hor63/hovImuBoard/hovImuBoard_BOM.xlsx

Reference | Value | Description | Digi-Key_PN | MPN | Manufacturer | Qty
> C1, C2 | 100nF | CAP CER 0.1UF 25V X7R 0603 Non-magnetic | 1608-1295-1-ND | 060330160104JXT | Knowles Syfer | 2
> C6, C7, C10, C25-C27 | 100nF | CAP CER 0.1UF 25V X7R 0603 | 311-1341-1-ND | CC0603KRX7R8BB104 | Yageo | 6
> C8, C9 | 20pF | CAP CER 20PF 50V C0G/NPO 0603 | 311-1424-1-ND | CC0603JRNPO9BN200 | Yageo | 2
> C3, C5, C12 | 4.7uF | CAP CER 4.7UF 25V X7R 1206 | 399-8204-1-ND | C1206C475K3RACTU | KEMET | 3
> C11, C13, C14, C16, C21 | 22uF | CAP CER 22UF 25V X7R 1210 | 1276-3392-1-ND | CL32B226KAJNNNE | Samsung Electro-Mechanics | 5
> D1, D2 | LED Green/Red | LED GREEN/RED CLEAR 4SMD | 754-1955-1-ND | APHB1608LZGKSURKC | Kingbright | 2
D3 | VESD16C1-02V-G3-08 | ESD PROTECTION DIODE 17V 6.3A SOD-523 | VESD16C1-02V-G3-08GICT-ND | VESD16C1-02V-G3-08 | Vishay Semiconductor Diodes Division | 1
H1 | Box |  | 377-1757-ND | CU-1935-MB | Bud Industries | 1
J1 | AVR-ISP-6 | TE_1761681-1 | A122759-ND | 1761681-1 | TE Connectivity AMP Connectors | 1
J3 | 54602-908LF | CONN MOD JACK 8P8C R/A UNSHLD | 609-1046-ND | 54602-908LF | Amphenol ICC (FCI) | 1
J4 | AVR-JTAG-10 | SHF-105-01-L-D-TH | SAM10711-ND | SHF-105-01-L-D-TH | Samtec Inc. | 1
L1 | 240nH | FIXED IND 240NH 2.4A 50 MOHM | 490-15988-1-ND | LQM21PNR24MEHD | Murata Electronics | 1
L2 | 1.2uH | FIXED IND 1.2UH 2.9A 36 MOHM | 490-14180-1-ND | 1231AS-H-1R2N=P3 | Murata Electronics | 1
L3 | 8.2uH | FIXED IND 8.2UH 1.3A 128 MOHM | 490-16860-1-ND | LQH43PN8R2M26L | Murata Electronics | 1
> L4, L5 | 2.2uH | FIXED IND 2.2UH 2.1A 78 MOHM | 490-15950-1-ND | LQH3NPN2R2MMEL | Murata Electronics | 2
R1 | 100k |  | 541-100KCCT-ND | CRCW0805100KFKEA | Vishay Dale | 1
> R2, R5 | 330 | RES SMD 330 OHM 1% 1/10W 0603 | P330HCT-ND | ERJ-3EKF3300V | Panasonic Electronic Components | 2
> R3, R7 | 787 | RES SMD 787 OHM 1% 1/10W 0603 | P787HCT-ND | ERJ-3EKF7870V | Panasonic Electronic Components | 2
R4 | 180m | RES 0.18 OHM 1% 1/2W 0805 | P19314CT-ND | ERJ-6DSFR18V | Panasonic Electronic Components | 1
R6 | 100 | RES SMD 100 OHM 1% 1/4W 0603 | P100BYCT-ND | ERJ-PA3F1000V | Panasonic Electronic Components | 1
> R8, R9 | 4.7k | RES SMD 4.7K OHM 1% 1/10W 0603 | P4.70KHCT-ND | ERJ-3EKF4701V | Panasonic Electronic Components | 2
R10 | 100k | RES SMD 100K OHM 1% 1/10W 0603 | P100KHCT-ND | ERJ-3EKF1003V | Panasonic Electronic Components | 1
> R11, R12 | 47 | RES SMD 47 OHM 1% 1/10W 0603 | P47.0HCT-ND | ERJ-3EKF47R0V | Panasonic Electronic Components | 2
S1 | MCSLPT4644B1PHTR |  | 450-3383-1-ND | MCSLPT4644B1PHTR | TE Connectivity ALCOSWITCH Switches | 1
U1 | LD2981 |  | 497-1524-1-ND | LD2981ABU33TR | STMicroelectronics | 1
U2 | BMX160 | Accelerometer, Gyroscope, Magnetometer, 3 Axis Sensor I²C, SPI Output | 828-1087-1-ND | BMX160 | Bosch Sensortec | 1
U3 | SN65LVDS179DR | LVDS TRANSCEIVER FULL 1/1 8SOIC | 296-46329-1-ND | SN65LVDS179DR | Texas Instruments | 1
U4 | ATmega1284P-AU | IC MCU 8BIT 128KB FLASH 44TQFP | ATmega1284P-AU-ND | ATmega1284P-AU | Microchip Technology | 1
U5 | TPS62173DSG | IC REG BUCK 5V 500MA 8WSON | 296-39450-1-ND | TPS62173DSGR | Texas Instruments | 1
U6 | TPS62172DSG | IC REG BUCK 3.3V 500MA 8WSON | 296-39449-1-ND | TPS62172DSGR | Texas Instruments | 1
XTAL1 | 9,216MHz | CRYSTAL 9.2160MHZ 20PF SMD | XC1274CT-ND | ECS-92.1-20-5PX-TR | ECS Inc. | 1
