hor63/hovImuBoard/hovSerialAdapter/hovSerialAdapter_BOM.xlsx

Reference | Value | Description | Digi-Key_PN | MPN | Manufacturer | Qty
C1 | 2.2uF | CAP CER 2.2UF 25V X7R 0805 | 1276-2954-1-ND | CL21B225KAFNNNE | Samsung Electro-Mechanics | 1
> C3-C9 | 100nF | CAP CER 0.1UF 25V X7R 0603 | 311-1341-1-ND | CC0603KRX7R8BB104 | Yageo | 7
C10 | 4.7uF | CAP CER 4.7UF 25V X7R 1206 | 399-8204-1-ND | C1206C475K3RACTU | KEMET | 1
> C2, C11-C13 | 22uF | CAP CER 22UF 25V X7R 1210 | 1276-3392-1-ND | CL32B226KAJNNNE | Samsung Electro-Mechanics | 4
> D1, D2 | VESD16C1-02V-G3-08 | ESD PROTECTION DIODE 17V 6.3A SOD-523 | VESD16C1-02V-G3-08GICT-ND | VESD16C1-02V-G3-08 | Vishay Semiconductor Diodes Division | 2
H1 | Box | BOX PLASTIC GRAY 2.56"L X 1.97"W | HM5530-ND | MB655030 | Hammond Manufacturing | 1
J2 | Power jack | CONN PWR JACK 2X5.5MM SOLDER | CP-036AHPJCT-ND | PJ-036AH-SMT-TR | CUI Devices | 1
J3 | DB9_Female | CONN DSUB RCPT 9POS SLDR CUP | L77SDE09S-ND | L77SDE09S | Amphenol ICC (Commercial Products) | 1
J4 | Ext. Power | PinHeader1x02 P2.54mm Vertical |  |  |  | 1
> J1, J5 | 54602-908LF | CONN MOD JACK 8P8C R/A UNSHLD | 609-1046-ND | 54602-908LF | Amphenol ICC (FCI) | 2
J6 | RX | PinHeader1x02 P2.54mm Vertical |  |  |  | 1
J7 | TX | PinHeader1x02 P2.54mm Vertical |  |  |  | 1
L1 | 4.7uH | FIXED IND 4.7UH 1.6A 90 MOHM SMD | 490-13388-1-ND | LQH43PN4R7M26L | Murata Electronics | 1
L2 | 240nH | FIXED IND 240NH 2.4A 50 MOHM | 490-15988-1-ND | LQM21PNR24MEHD | Murata Electronics | 1
L3 | 1.2uH | FIXED IND 1.2UH 2.9A 36 MOHM | 490-14180-1-ND | 1231AS-H-1R2N=P3 | Murata Electronics | 1
L4 | 8.2uH | FIXED IND 8.2UH 1.3A 153.6 MOHM | 490-16115-1-ND | LQH43PH8R2M26L | Murata Electronics | 1
L5 | 2.2uH | FIXED IND 2.2UH 2.1A 78 MOHM | 490-15950-1-ND | LQH3NPN2R2MMEL | Murata Electronics | 1
LOGO1 | Logo_Open_Hardware_Small |  |  |  |  | 1
R1 | 1.5 | RES SMD 1.5 OHM 1% 1/2W 0805 | P19272CT-ND | ERJ-6DQF1R5V | Panasonic Electronic Components | 1
R2 | 100 | RES SMD 100 OHM 1% 1/4W 0603 | P100BYCT-ND | ERJ-PA3F1000V | Panasonic Electronic Components | 1
R3 | 180m | RES 0.18 OHM 1% 1/2W 0805 | P19314CT-ND | ERJ-6DSFR18V | Panasonic Electronic Components | 1
TP1 | +12V |  |  |  |  | 1
TP2 | +3.3V |  |  |  |  | 1
U1 | MAX3232 | IC TRANSCEIVER FULL 2/2 16TSSOP | 296-13100-1-ND | MAX3232IPWR | Texas Instruments | 1
U2 | SN65LVDS179DR | LVDS TRANSCEIVER FULL 1/1 8SOIC | 296-46329-1-ND | SN65LVDS179DR | Texas Instruments | 1
U3 | TPS62172DSG | IC REG BUCK 3.3V 500MA 8WSON | 296-39449-1-ND | TPS62172DSGR | Texas Instruments | 1
