hor63/hovImuBoard/hovSerialAdapter/hovSerialAdapter.kicad_pcb

## KiCad design hovSerialAdapter/hovSerialAdapter.kicad_pcb (2022-01-31)

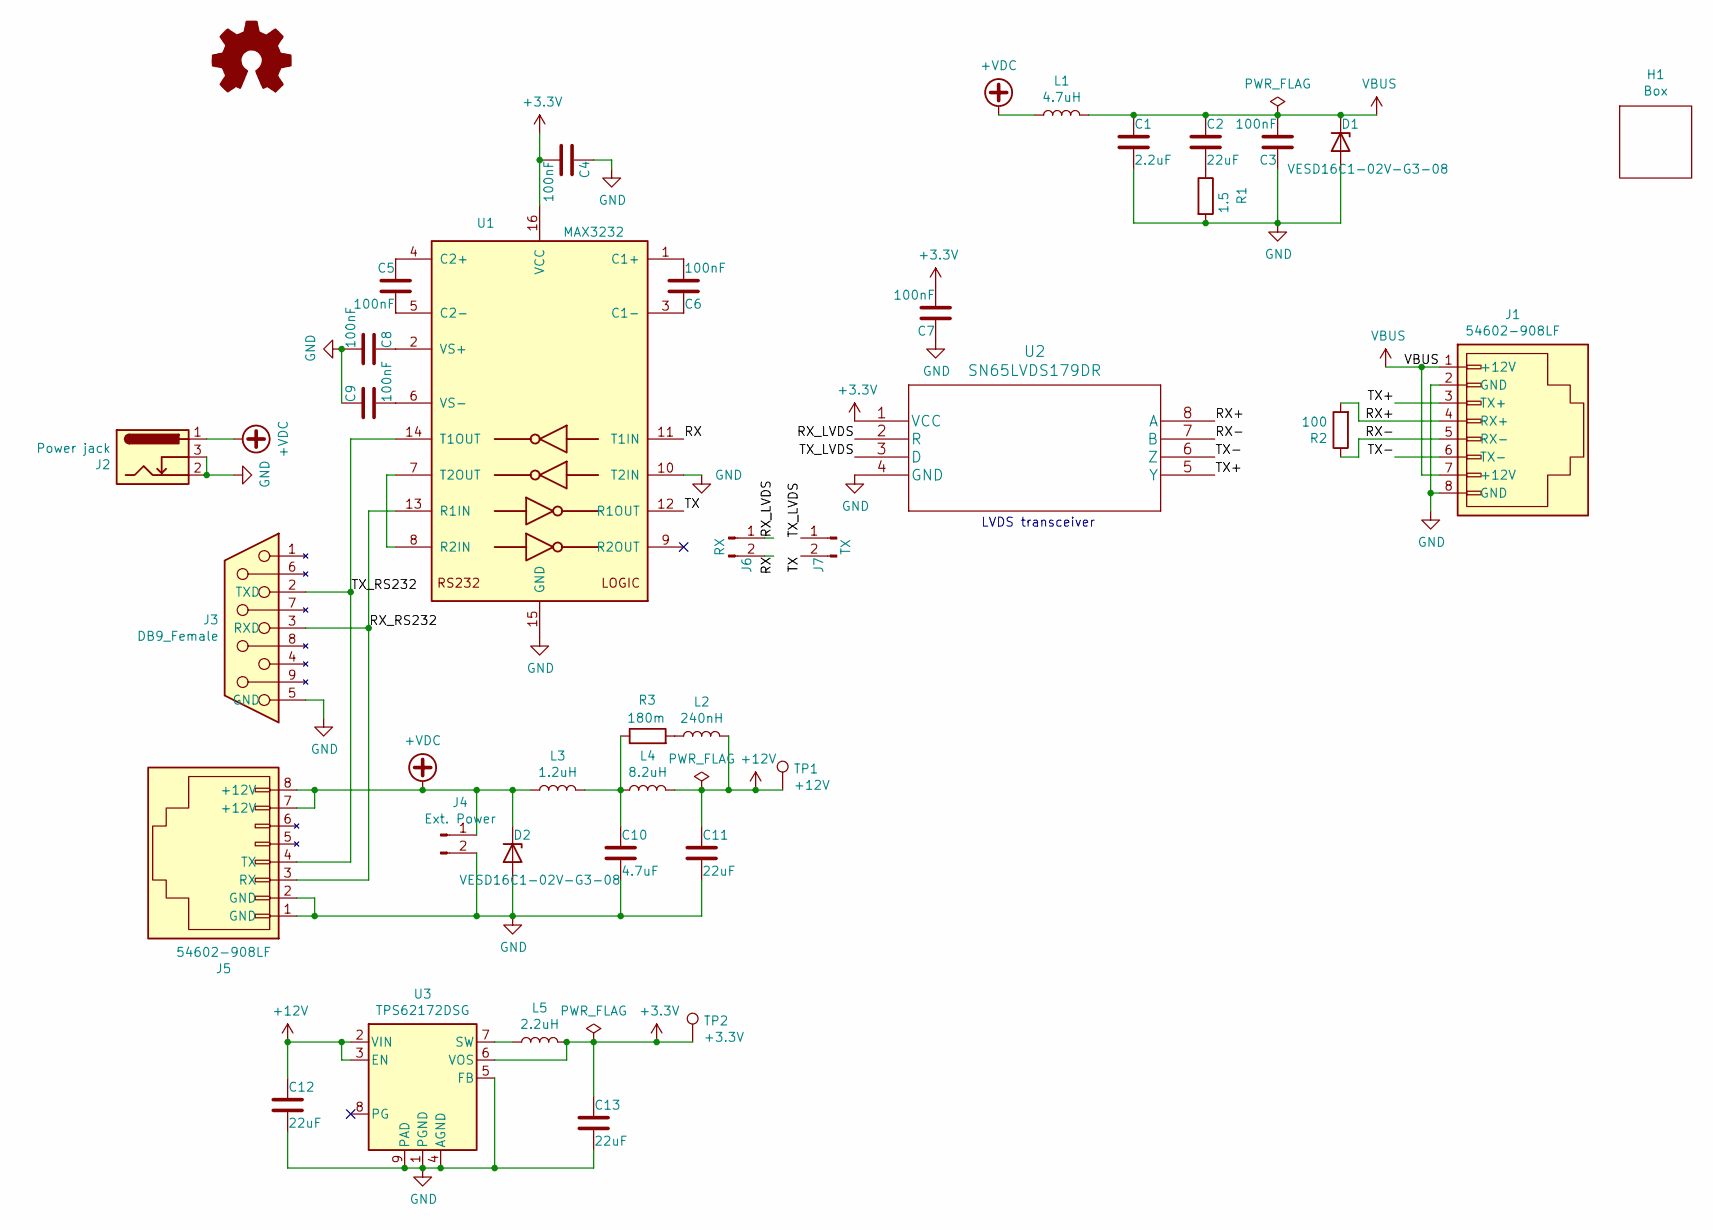
[picture p1: schematic hovSerialAdapter.kicad_sch, horOpenVario serial converter for IMU board]

Parts:
C1: 2.2uF; C_0805_2012Metric; MPN CL21B225KAFNNNE; Digi-Key_PN 1276-2954-1-ND
C2, C11, C12, C13: 22uF; C_1210_3225Metric; MPN CL32B226KAJNNNE; Digi-Key_PN 1276-3392-1-ND
C3, C4, C5, C6, C7, C8, C9: 100nF; C_0603_1608Metric; MPN CC0603KRX7R8BB104; Digi-Key_PN 311-1341-1-ND
C10: 4.7uF; C_1206_3216Metric; MPN C1206C475K3RACTU; Digi-Key_PN 399-8204-1-ND
D1, D2: VESD16C1-02V-G3-08; D_SOD-523; MPN VESD16C1-02V-G3-08; Digi-Key_PN VESD16C1-02V-G3-08GICT-ND
H1: Box; Box-MB655030; MPN MB655030; Digi-Key_PN HM5530-ND
J1, J5: 54602-908LF; Ethernet_Jack_54602-908LF; MPN 54602-908LF; Digi-Key_PN 609-1046-ND
J2: Power jack; CUI_PJ-036AH-SMT-TR; MPN PJ-036AH-SMT-TR; Digi-Key_PN CP-036AHPJCT-ND
J3: DB9_Female; DSUB-9_Female_EdgeMount_P2.77mm; MPN L77SDE09S; Digi-Key_PN L77SDE09S-ND
J4: Ext. Power; PinHeader_1x02_P2.54mm_Vertical
J6: RX; PinHeader_1x02_P2.54mm_Vertical
J7: TX; PinHeader_1x02_P2.54mm_Vertical
L1: 4.7uH; L_1812_4532Metric; MPN LQH43PN4R7M26L; Digi-Key_PN 490-13388-1-ND
L2: 240nH; L_0805_2012Metric; MPN LQM21PNR24MEHD; Digi-Key_PN 490-15988-1-ND
L3: 1.2uH; IND_1231AS-H-1R2N=P3; MPN 1231AS-H-1R2N=P3; Digi-Key_PN 490-14180-1-ND
L4: 8.2uH; IND_LQH43PH8R2M26L; MPN LQH43PH8R2M26L; Digi-Key_PN 490-16115-1-ND
L5: 2.2uH; IND_LQH3NPN2R2MMEL; MPN LQH3NPN2R2MMEL; Digi-Key_PN 490-15950-1-ND
LOGO1: Logo_Open_Hardware_Small; OSHW-Symbol_6.7x6mm_SilkScreen
R1: 1.5; R_0805_2012Metric; MPN ERJ-6DQF1R5V; Digi-Key_PN P19272CT-ND
R2: 100; R_0603_1608Metric; MPN ERJ-PA3F1000V; Digi-Key_PN P100BYCT-ND
R3: 180m; R_0805_2012Metric; MPN ERJ-6DSFR18V; Digi-Key_PN P19314CT-ND
TP1: +12V; TestPoint_THTPad_D1.0mm_Drill0.5mm
TP2: +3.3V; TestPoint_THTPad_D1.0mm_Drill0.5mm
U1: MAX3232; TSSOP-16_4.4x5mm_P0.65mm; MPN MAX3232IPWR; Digi-Key_PN 296-13100-1-ND
U2: SN65LVDS179DR; SOIC-8_3.9x4.9mm_P1.27mm; MPN SN65LVDS179DR; Digi-Key_PN 296-46329-1-ND
U3: TPS62172DSG; WSON-8-1EP_2x2mm_P0.5mm_EP0.9x1.6mm_ThermalVias; MPN TPS62172DSGR; Digi-Key_PN 296-39449-1-ND

Connections:
+3V3: C4.1, C7.1, C13.2, L5.2, TP2.1, U1.16 (VCC), U2.1 (VCC), U3.6 (VOS)
+12V: C11.2, C12.2, L2.2, L4.2, TP1.1, U3.2 (VIN), U3.3 (EN)
+VDC: D2.1 (K), J2.1, J4.1, J5.7 (+12V), J5.8 (+12V), L1.1, L3.1
/RX: J6.2, U1.11 (T1IN)
/RX+: J1.4 (RX+), R2.2, U2.8 (A)
/RX-: J1.5 (RX-), R2.1, U2.7 (B)
/RX_LVDS: J6.1, U2.2 (R)
/RX_RS232: J3.3 (RXD), J5.3 (RX), U1.13 (R1IN)
/TX: J7.2, U1.12 (R1OUT)
/TX+: J1.3 (TX+), U2.5 (Y)
/TX-: J1.6 (TX-), U2.6 (Z)
/TX_LVDS: J7.1, U2.3 (D)
/TX_RS232: J3.2 (TXD), J5.4 (TX), U1.14 (T1OUT)
GND: C1.1, C3.2, C4.2, C7.2, C8.1, C9.2, C10.1, C11.1, C12.1, C13.1, D1.2 (A), D2.2 (A), J1.2 (GND), J1.8 (GND), J2.2, J2.3, J3.5 (GND), J4.2, J5.1 (GND), J5.2 (GND), R1.2, U1.10 (T2IN), U1.15 (GND), U2.4 (GND), U3.1 (PGND), U3.4 (AGND), U3.5 (FB), U3.9 (PAD)
unnamed: C2.1, R1.1
unnamed: C5.1, U1.5 (C2-)
unnamed: C5.2, U1.4 (C2+)
unnamed: C6.1, U1.1 (C1+)
unnamed: C6.2, U1.3 (C1-)
unnamed: C8.2, U1.2 (VS+)
unnamed: C9.1, U1.6 (VS-)
unnamed: C10.2, L3.2, L4.1, R3.1
unnamed: L2.1, R3.2
unnamed: L5.1, U3.7 (SW)
unnamed: U1.7 (T2OUT), U1.8 (R2IN)
VBUS: C1.2, C2.2, C3.1, D1.1 (K), J1.1 (+12V), J1.7 (+12V), L1.2

Notes on the sheet:
LVDS transceiver

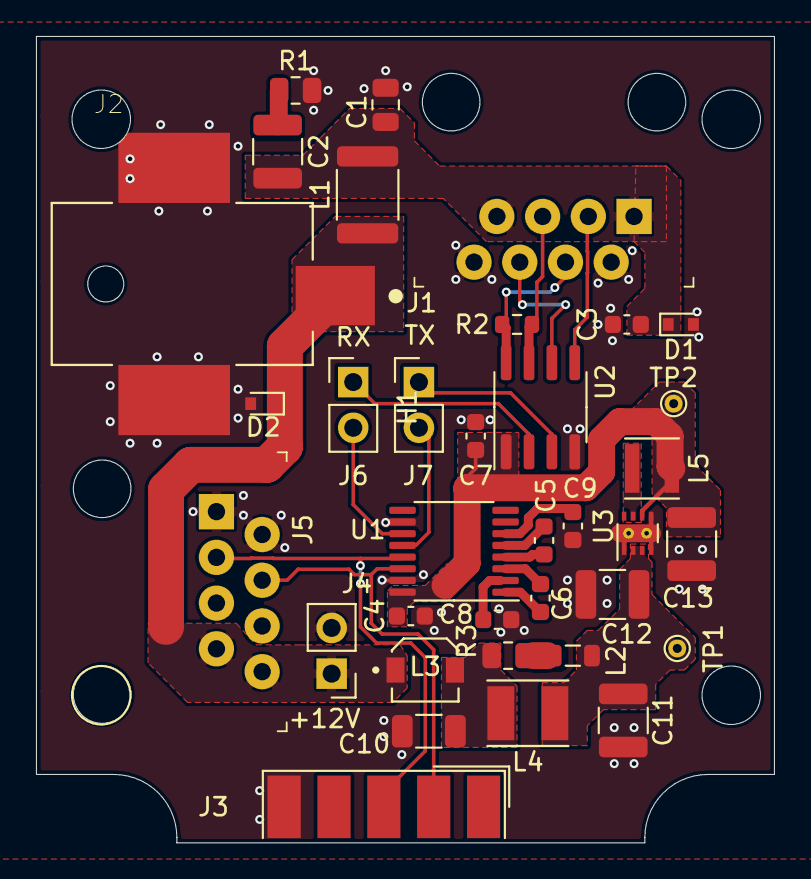
[picture p2: board hovSerialAdapter.kicad_pcb from above]

Board: 2 copper layers, 41.0 x 44.8 mm, 37 parts (1 on the bottom side), 26 nets.
