hor63/hovImuBoard/hovImuBoard.kicad_pcb

## KiCad design hovImuBoard.kicad_pcb (2022-01-31)

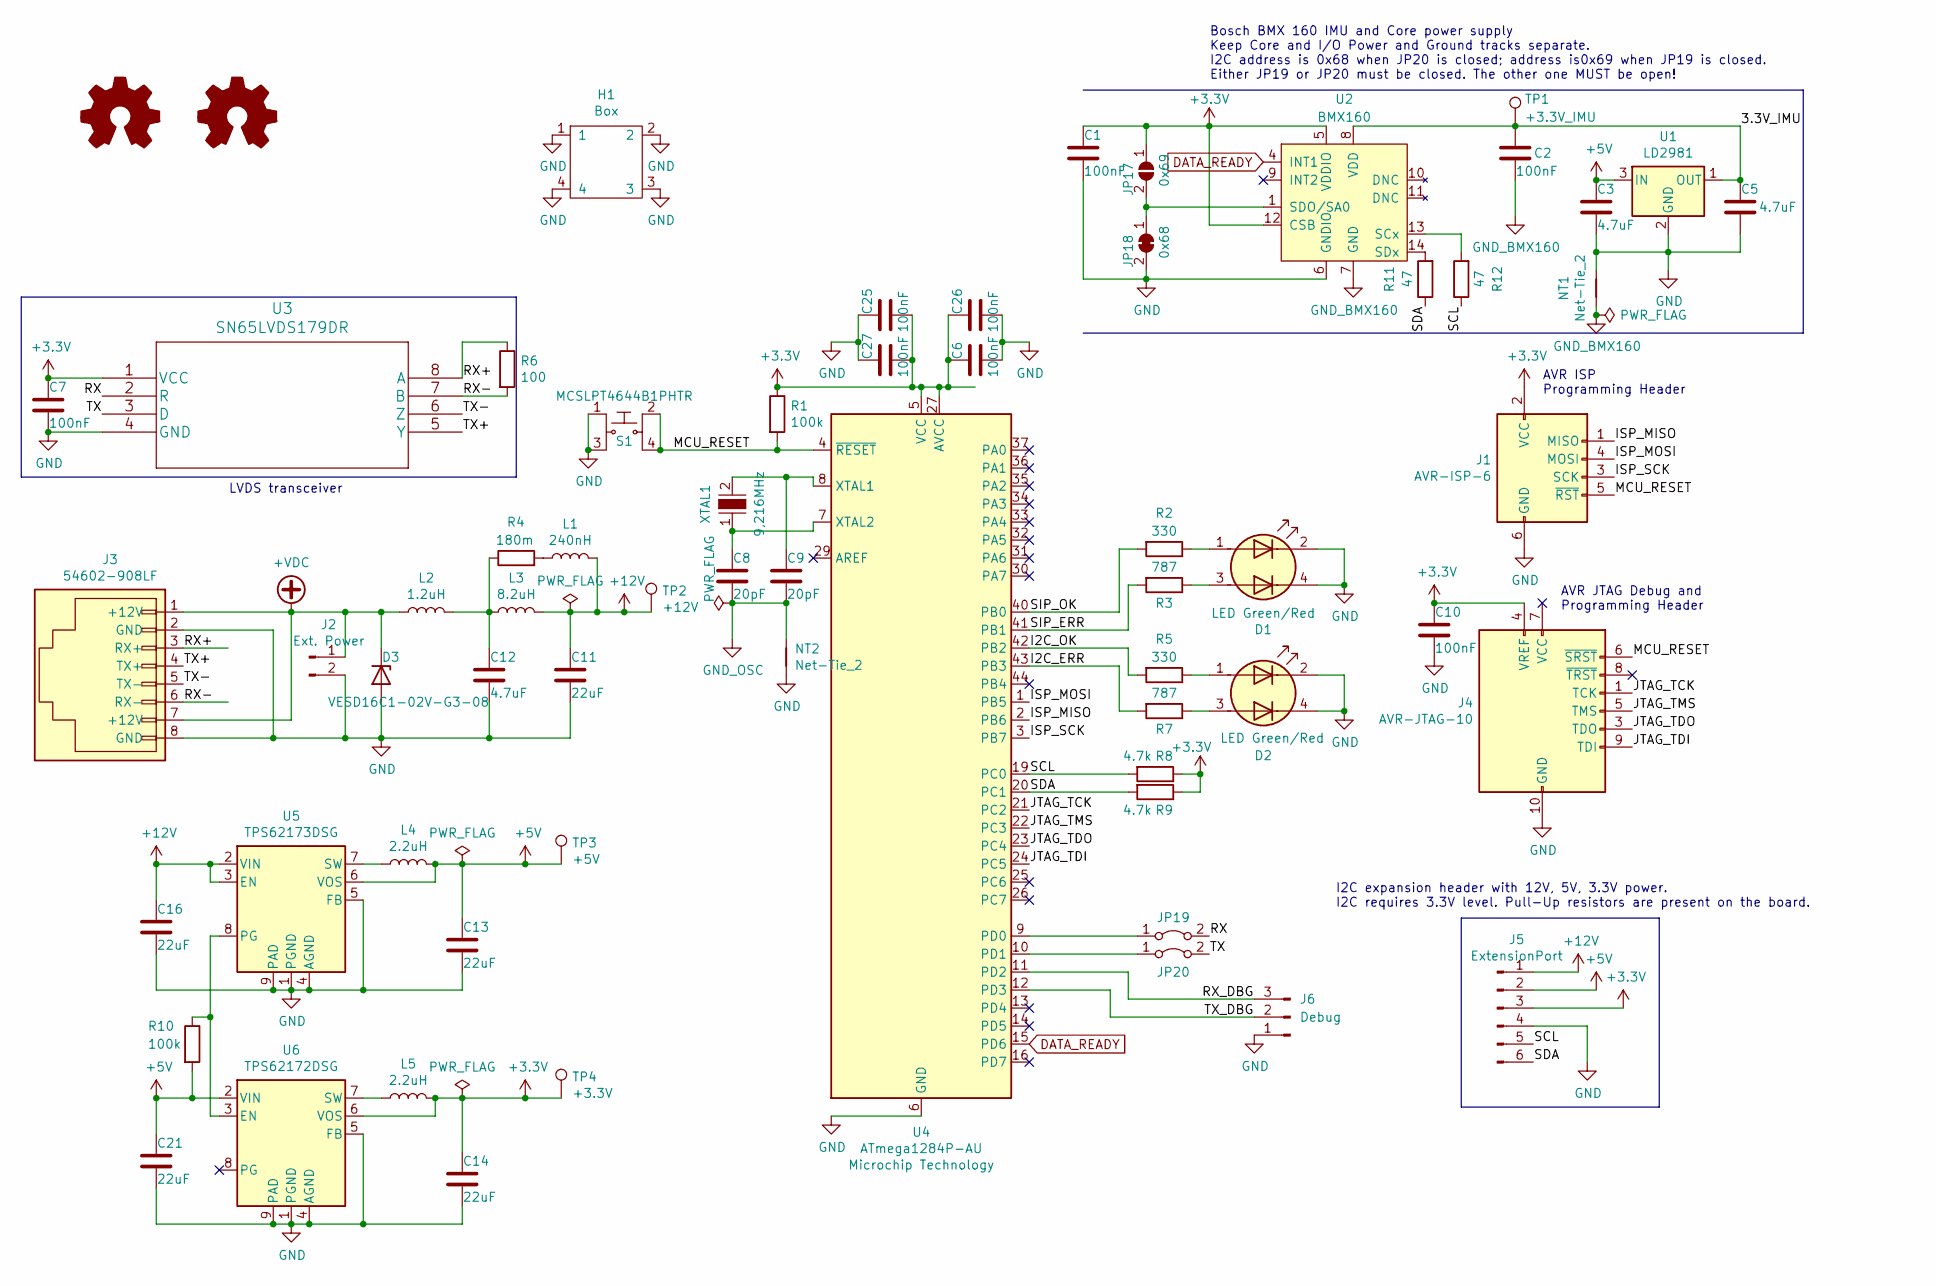
[picture p3: schematic hovImuBoard.kicad_sch, horOpenVario IMU sensorboard]

Parts:
C1, C2: 100nF; C_0603_1608Metric; MPN 060330160104JXT; Digi-Key_PN 1608-1295-1-ND
C3, C5, C12: 4.7uF; C_1206_3216Metric; MPN C1206C475K3RACTU; Digi-Key_PN 399-8204-1-ND
C6, C7, C10, C25, C26, C27: 100nF; C_0603_1608Metric; MPN CC0603KRX7R8BB104; Digi-Key_PN 311-1341-1-ND
C8, C9: 20pF; C_0603_1608Metric; MPN CC0603JRNPO9BN200; Digi-Key_PN 311-1424-1-ND
C11, C13, C14, C16, C21: 22uF; C_1210_3225Metric; MPN CL32B226KAJNNNE; Digi-Key_PN 1276-3392-1-ND
D1, D2: LED Green/Red; LED_APHB1608LZGKSURKC; MPN APHB1608LZGKSURKC; Digi-Key_PN 754-1955-1-ND
D3: VESD16C1-02V-G3-08; D_SOD-523; MPN VESD16C1-02V-G3-08; Digi-Key_PN VESD16C1-02V-G3-08GICT-ND
H1: Box; Box-CU-1935-MB; MPN CU-1935-MB; Digi-Key_PN 377-1757-ND
J1: AVR-ISP-6; TE_1761681-1; MPN 1761681-1; Digi-Key_PN A122759-ND
J2: Ext. Power; PinHeader_1x02_P2.54mm_Vertical
J3: 54602-908LF; Ethernet_Jack_54602-908LF; MPN 54602-908LF; Digi-Key_PN 609-1046-ND
J4: AVR-JTAG-10; PinHeader_2x5_P1.27mm_Drill.7mm; MPN SHF-105-01-L-D-TH; Digi-Key_PN SAM10711-ND
J5: ExtensionPort; PinHeader_1x06_P2.54mm_Vertical
J6: Debug; PinHeader_1x03_P2.54mm_Vertical
JP17: 0x69; SolderJumper-2_P1.3mm_Open_RoundedPad1.0x1.5mm
JP18: 0x68; SolderJumper-2_P1.3mm_Bridged_RoundedPad1.0x1.5mm
JP19, JP20: Jumper_2_Bridged; PinHeader_1x02_P2.54mm_Vertical
L1: 240nH; L_0805_2012Metric; MPN LQM21PNR24MEHD; Digi-Key_PN 490-15988-1-ND
L2: 1.2uH; IND_1231AS-H-1R2N=P3; MPN 1231AS-H-1R2N=P3; Digi-Key_PN 490-14180-1-ND
L3: 8.2uH; L_1812_4532Metric; MPN LQH43PN8R2M26L; Digi-Key_PN 490-16860-1-ND
L4, L5: 2.2uH; IND_LQH3NPN2R2MMEL; MPN LQH3NPN2R2MMEL; Digi-Key_PN 490-15950-1-ND
LOGO1, LOGO2: Logo_Open_Hardware_Small; OSHW-Symbol_6.7x6mm_Copper
NT1: Net-Tie_2; NetTie-2_SMD_Pad2.0mm
NT2: Net-Tie_2; NetTie-2_SMD_Pad0.5mm
R1: 100k; R_0805_2012Metric; MPN CRCW0805100KFKEA; Digi-Key_PN 541-100KCCT-ND
R2, R5: 330; R_0603_1608Metric; MPN ERJ-3EKF3300V; Digi-Key_PN P330HCT-ND
R3, R7: 787; R_0603_1608Metric; MPN ERJ-3EKF7870V; Digi-Key_PN P787HCT-ND
R4: 180m; R_0805_2012Metric; MPN ERJ-6DSFR18V; Digi-Key_PN P19314CT-ND
R6: 100; R_0603_1608Metric; MPN ERJ-PA3F1000V; Digi-Key_PN P100BYCT-ND
R8, R9: 4.7k; R_0603_1608Metric; MPN ERJ-3EKF4701V; Digi-Key_PN P4.70KHCT-ND
R10: 100k; R_0603_1608Metric; MPN ERJ-3EKF1003V; Digi-Key_PN P100KHCT-ND
R11, R12: 47; R_0603_1608Metric; MPN ERJ-3EKF47R0V; Digi-Key_PN P47.0HCT-ND
S1: MCSLPT4644B1PHTR; PB_MCSLPT4644B1PHTR; MPN MCSLPT4644B1PHTR; Digi-Key_PN 450-3383-1-ND
TP1: +3.3V_IMU; TestPoint_THTPad_D1.0mm_Drill0.5mm
TP2: +12V; TestPoint_THTPad_D1.0mm_Drill0.5mm
TP3: +5V; TestPoint_THTPad_D1.0mm_Drill0.5mm
TP4: +3.3V; TestPoint_THTPad_D1.0mm_Drill0.5mm
U1: LD2981; SOT-89-3; MPN LD2981ABU33TR; Digi-Key_PN 497-1524-1-ND
U2: BMX160; Bosch_LGA-14_3x2.5mm_P0.5mm; MPN BMX160; Digi-Key_PN 828-1087-1-ND
U3: SN65LVDS179DR; SOIC-8_3.9x4.9mm_P1.27mm; MPN SN65LVDS179DR; Digi-Key_PN 296-46329-1-ND
U4: ATmega1284P-AU; TQFP-44_10x10mm_P0.8mm; MPN ATmega1284P-AU; Digi-Key_PN ATmega1284P-AU-ND
U5: TPS62173DSG; WSON-8-1EP_2x2mm_P0.5mm_EP0.9x1.6mm_ThermalVias; MPN TPS62173DSGR; Digi-Key_PN 296-39450-1-ND
U6: TPS62172DSG; WSON-8-1EP_2x2mm_P0.5mm_EP0.9x1.6mm_ThermalVias; MPN TPS62172DSGR; Digi-Key_PN 296-39449-1-ND
XTAL1: 9,216MHz; Crystal_SMD_HC49-SD; MPN ECS-92.1-20-5PX-TR; Digi-Key_PN XC1274CT-ND

Connections:
+3V3: C1.2, C6.2, C7.2, C10.2, C14.2, C25.1, C26.2, C27.1, J1.2 (VCC), J4.4 (VREF), J5.3, JP17.1 (A), L5.2, R1.1, R8.1, R9.1, TP4.1, U2.5 (VDDIO), U2.12 (CSB), U3.1 (VCC), U4.5 (VCC), U4.17 (VCC), U4.27 (AVCC), U4.38 (VCC), U6.6 (VOS)
+5V: C3.2, C13.2, C21.2, J5.2, L4.2, R10.2, TP3.1, U1.3 (IN), U5.6 (VOS), U6.2 (VIN)
+12V: C11.2, C16.2, J5.1, L1.2, L3.2, TP2.1, U5.2 (VIN), U5.3 (EN)
+VDC: D3.1 (K), J2.1, J3.1 (+12V), J3.7 (+12V), L2.1
/3.3V_IMU: C2.2, C5.2, TP1.1, U1.1 (OUT), U2.8 (VDD)
/DATA_READY: U2.4 (INT1), U4.15 (PD6)
/I2C_ERR: R7.2, U4.43 (PB3)
/I2C_OK: R5.2, U4.42 (PB2)
/ISP_MISO: J1.1 (MISO), U4.2 (PB6)
/ISP_MOSI: J1.4 (MOSI), U4.1 (PB5)
/ISP_SCK: J1.3 (SCK), U4.3 (PB7)
/JTAG_TCK: J4.1 (TCK), U4.21 (PC2)
/JTAG_TDI: J4.9 (TDI), U4.24 (PC5)
/JTAG_TDO: J4.3 (TDO), U4.23 (PC4)
/JTAG_TMS: J4.5 (TMS), U4.22 (PC3)
/MCU_RESET: J1.5 (~RST), J4.6 (~SRST), R1.2, S1.2, S1.4, U4.4 (~RESET)
/RX: JP19.2 (B), U3.2 (R)
/RX+: J3.3 (RX+), R6.1, U3.8 (A)
/RX-: J3.6 (RX-), R6.2, U3.7 (B)
/RX_DBG: J6.3, U4.11 (PD2)
/SCL: J5.5, R8.2, R12.1, U4.19 (PC0)
/SDA: J5.6, R9.2, R11.1, U4.20 (PC1)
/SIP_ERR: R3.2, U4.41 (PB1)
/SIP_OK: R2.2, U4.40 (PB0)
/TX: JP20.2 (B), U3.3 (D)
/TX+: J3.4 (TX+), U3.5 (Y)
/TX-: J3.5 (TX-), U3.6 (Z)
/TX_DBG: J6.2, U4.12 (PD3)
GND: C1.1, C3.1, C5.1, C6.1, C7.1, C10.1, C11.1, C12.1, C13.1, C14.1, C16.1, C21.1, C25.2, C26.1, C27.2, D1.2 (K1), D1.4 (K2), D2.2 (K1), D2.4 (K2), D3.2 (A), H1.1, H1.2, H1.3, H1.4, J1.6 (GND), J2.2, J3.2 (GND), J3.8 (GND), J4.2 (GND), J4.10 (GND), J5.4, J6.1, JP18.2 (B), NT1.2, NT2.2, S1.1, S1.3, U1.2 (GND), U2.6 (GNDIO), U3.4 (GND), U4.6 (GND), U4.18 (GND), U4.28 (GND), U4.39 (GND), U5.1 (PGND), U5.4 (AGND), U5.5 (FB), U5.9 (PAD), U6.1 (PGND), U6.4 (AGND), U6.5 (FB), U6.9 (PAD)
GND_BMX160: C2.1, NT1.1, U2.2 (GND), U2.3 (GND), U2.7 (GND)
GND_OSC: C8.1, C9.1, NT2.1
unnamed: C8.2, U4.7 (XTAL2), XTAL1.1
unnamed: C9.2, U4.8 (XTAL1), XTAL1.2
unnamed: C12.2, L2.2, L3.1, R4.1
unnamed: D1.1 (A1), R2.1
unnamed: D1.3 (A2), R3.1
unnamed: D2.1 (A1), R5.1
unnamed: D2.3 (A2), R7.1
unnamed: JP17.2 (B), JP18.1 (A), U2.1 (SDO/SA0)
unnamed: JP19.1 (A), U4.9 (PD0)
unnamed: JP20.1 (A), U4.10 (PD1)
unnamed: L1.1, R4.2
unnamed: L4.1, U5.7 (SW)
unnamed: L5.1, U6.7 (SW)
unnamed: R10.1, U5.8 (PG), U6.3 (EN)
unnamed: R11.2, U2.14 (SDx)
unnamed: R12.2, U2.13 (SCx)

Notes on the sheet:
I2C expansion header with 12V, 5V, 3.3V power. I2C requires 3.3V level. Pull-Up resistors are present on the board.
AVR JTAG Debug and Programming Header
LVDS transceiver
AVR ISP Programming Header
Bosch BMX 160 IMU and Core power supply Keep Core and I/O Power and Ground tracks separate. I2C address is 0x68 when JP20 is closed; address is0x69 when JP19 is closed. Either JP19 or JP20 must be closed. The other one MUST be open!

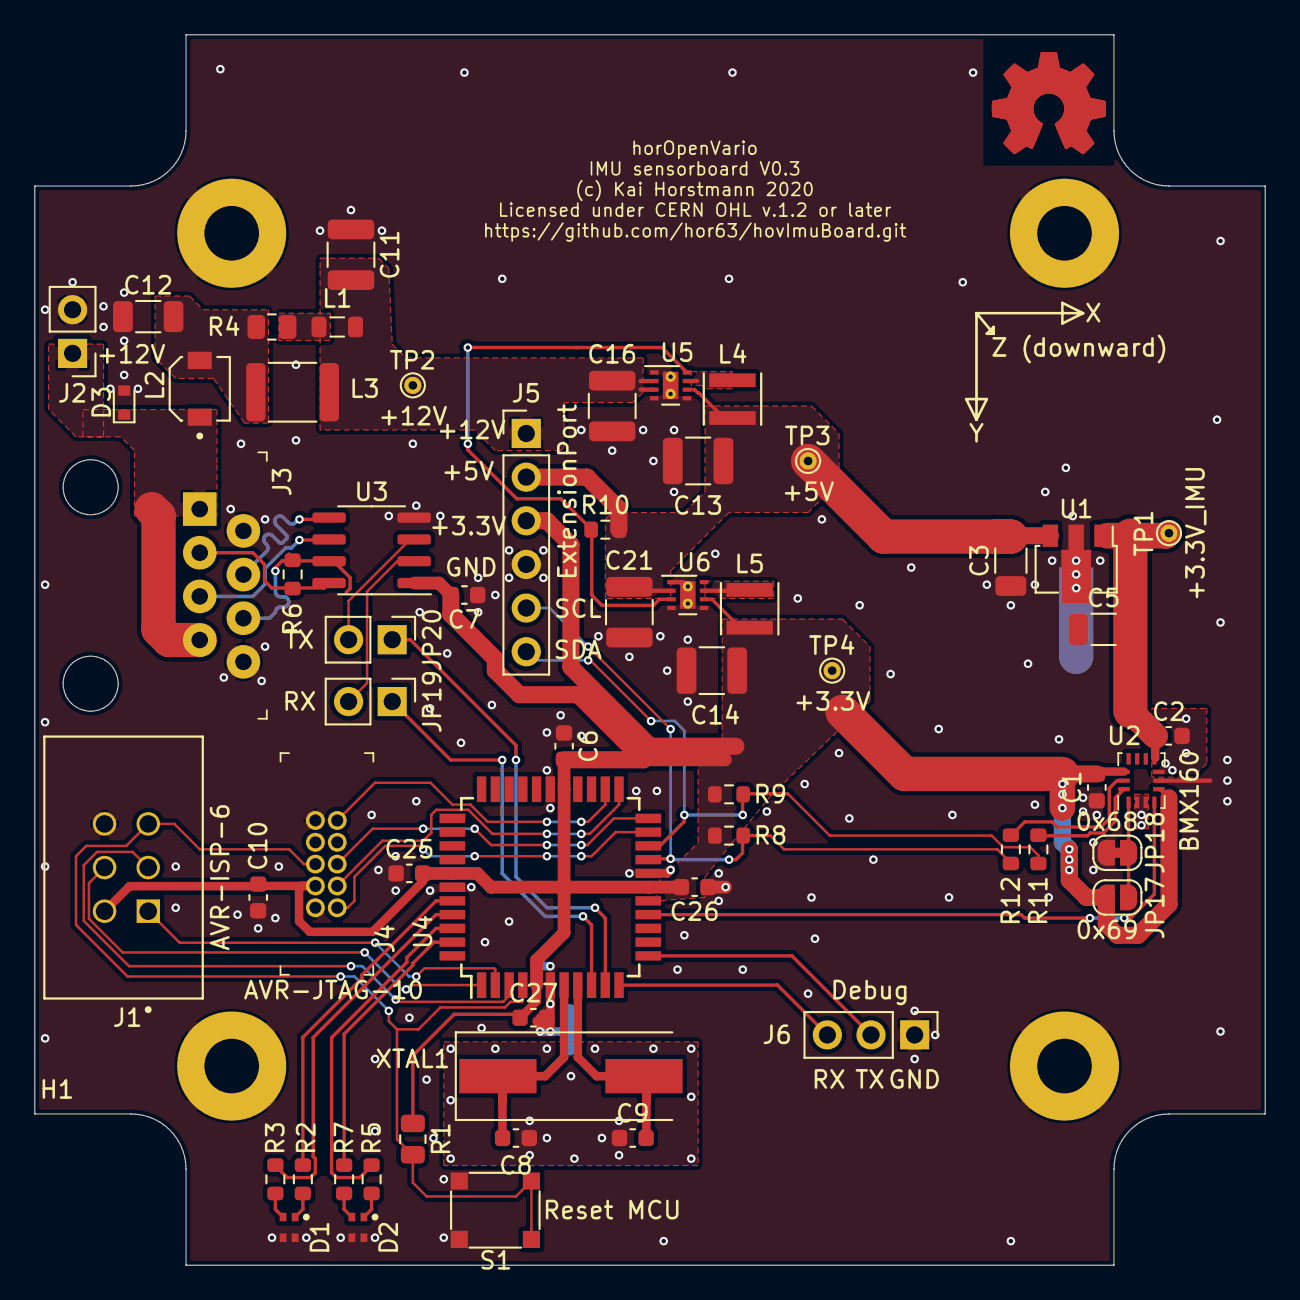
[picture p4: board hovImuBoard.kicad_pcb from above]

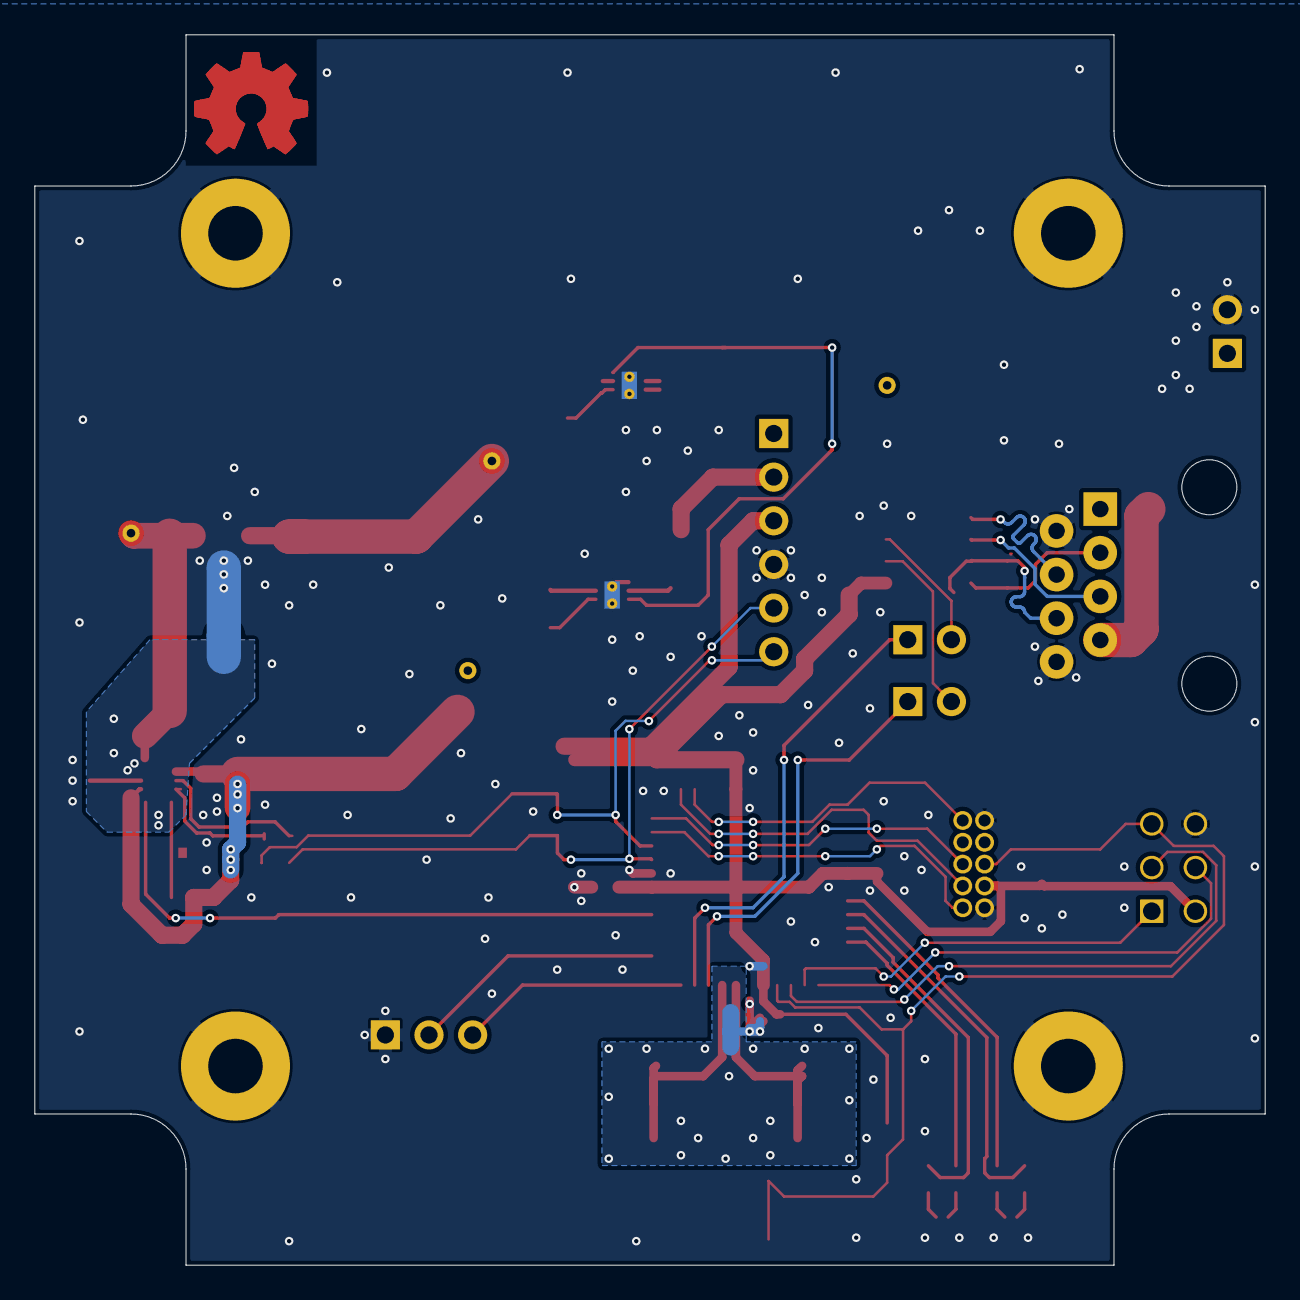
[picture p5: board hovImuBoard.kicad_pcb from below]

Board: 2 copper layers, 71.6 x 71.6 mm, 65 parts (2 on the bottom side), 47 nets.
