hor63/hovImuBoard/(commit log)

2019-08-19 Initial checkin of WIP
    [Calculation-of-2-section-input-filter.xlsx, hovImuBoard.csv, hovImuBoard.kicad_pcb, hovImuBoard.sch]
2019-08-20 First shot routing the board
    Simplified the design: The IP address is not configurable with solder jumpers any more.
    [hovImuBoard.kicad_pcb, hovImuBoard.sch]
2019-08-22 Re-arrange expansion port and LEDs. Route power further apart from the BMX160 Add mounting holes.
    [hovImuBoard.kicad_pcb, hovImuBoard.sch]
2019-09-06 Apply corrections from V0.1; Fit board to a plastic box
    [hovImuBoard.kicad_pcb, hovImuBoard.sch, hovImuBoard_BOM.xlsx]
2019-09-06 Correct L4 and L5 to 2.2uH. Update BOM
    [hovImuBoard.kicad_pcb, hovImuBoard.sch, hovImuBoard_BOM.xlsx]
2019-09-20 Remove superfluous fields from symbols like Digi-Key data sheets, or family
    [hovImuBoard.sch]
2019-09-20 Update BOM
    [hovImuBoard_BOM.xlsx]
2019-09-20 Optimize the layout.
    Re-route tracks inside the screw hole.
    Remove some vias connecting the ground planes.
    Re-route tracks inside the ATMega to allow better connection between ground planes.
    Overlay ground copper zones to add thermal relief to manually soldered items.
    [hovImuBoard.kicad_pcb]
2019-10-06 Update ATMega1284P datasheet link, add datasheets of active parts.
    [hovImuBoard.sch]
2020-07-09 WIP: Redesign of the sensor board.
    Major re-design:
    - LVDS instead of RS422 driver
    - Simplify buck converter design.
    - Make the back-plane mostly un-interrupted.
    - Smaller cpacitors, eliminate tantal capacitors.
    - Make ESD diode smaller.
    - Pick different parts.
    - Smaller LEDs.
    - Eliminate the diodes at the buck converters.
    [Calculation-of-2-section-input-filter.xlsx, hovImuBoard.kicad_pcb, hovImuBoard.sch]
2020-07-10 Complete re-design of hovImuBoard
    - Create a proper local ground plane for the oscillator
    - Create a local ground plane for the analog and digital ground.
    - Clean separation of VDD and VDDIO, and ground lines for I/O.
    - Hook up INT1 of the IMU with pin 15 of the MCU
    [hovImuBoard.kicad_pcb, hovImuBoard.sch]
2020-07-15 Rev. is 0.3, minor trace optimiztions.
    [hovImuBoard.kicad_pcb, hovImuBoard.sch, hovImuBoard_BOM.xlsx]
2020-07-15 Add directory hovSerialAdapter
    Add new PCB as converter from RS-232 or TTL level to LVDS to the
    IMU board.
    The serial converter board also provides filtered power to the IMU board.
    Un-filtered power can come either from a IGC compatible RJ-45 jack, a 2mm/5mm barrel jack
    or just pin headers.
    Add reference to project symbol tables
    [Calculation-of-2-section-input-filter.xlsx, hovSerialAdapter.kicad_pcb, hovSerialAdapter.sch]
2020-07-26 Finalize design of serial adapter board V0.1
    Add box symbol and footprint.
    Finishing touches on the routings
    [hovSerialAdapter.kicad_pcb, hovSerialAdapter.sch, hovSerialAdapter_BOM.xlsx]
2020-07-26 Remove one power symbol
    [hovImuBoard.sch]
2020-08-05 hovSerialAdapter: Add 3D models from SnapEDA.
    Add 3D models from SnapEDA to the footprints of the RJ-45 jack, and for the 8.2uH inductivity
    [hovSerialAdapter.kicad_pcb, hovSerialAdapter.sch, hovSerialAdapter_BOM.xlsx]
2020-08-07 hovSerialAdapter: Add 3D model for the D-Sub connector.
    Copy the footprint to lib/hovImuBoard.pretty, and add the 3D model.
    Improve the switching trace on the 3.3V regulator, moving the feedback further out of the way
    [hovSerialAdapter.kicad_pcb, hovSerialAdapter.sch]
2021-06-24 Doc: Add LVDS driver sn65lvds179 datasheet
2021-06-24 Serial adapter: Update BOM
    [hovSerialAdapter_BOM.xlsx]
2021-06-24 Update KiCad, and libraries
    [hovImuBoard.sch]
2022-01-31 Conversion to KiCad 6.0, add 3D models
    First commit after successful conversion.
    Save first before cleanup of outdated KiCad 5 files. Just to be sure.
    Added missing 3D models for various parts. Downloaded from SNAP-EDA or
    directly from the manufacturer's site.
    [hovImuBoard.kicad_pcb, hovImuBoard.kicad_sch, hovSerialAdapter.kicad_pcb, hovSerialAdapter.kicad_sch]
2022-05-13 Doc: Add u-Blox 6 module datasheet and long-distance setup for UBlox module.
    The long-distance setup uses the IMU board and the serial converter board to
    bridge longer distance (i.e. from my desk out to the patio) with a long
    Ethernet patch cable using the LVDS data and power connection between the two
    boards.
