hor63/hovImuBoard/(notices)

Notices in the files:
hovImuBoard.kicad_pcb:
Licensed under CERN OHL v.1.2 or later
